sakg-dev/keebiter/kicad/3d_files/2u_stabalizer.step

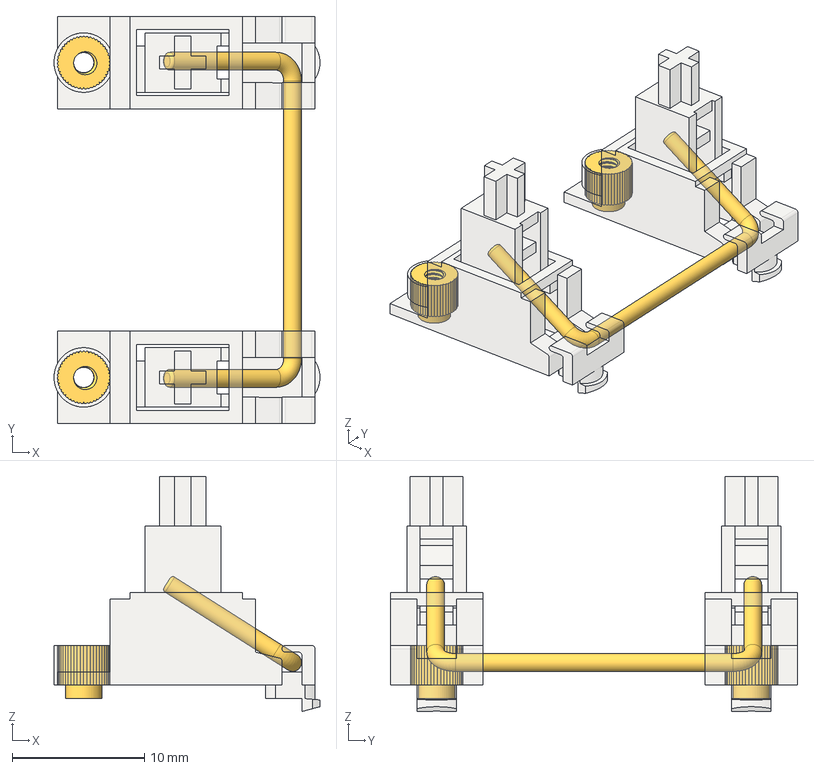
[picture p2: CAD file, 2026-10-14]
kicad/3d_files/2u_stabalizer.step
20.1 x 30.8 x 17.8 mm
Stabilizer Housing x 2
M2 Insert x 2
Stabilizer Insert x 2
2U Stabilizer Bar
