sakg-dev/keebiter/kicad/3d_files/keycaps/keycap_2_75u.step

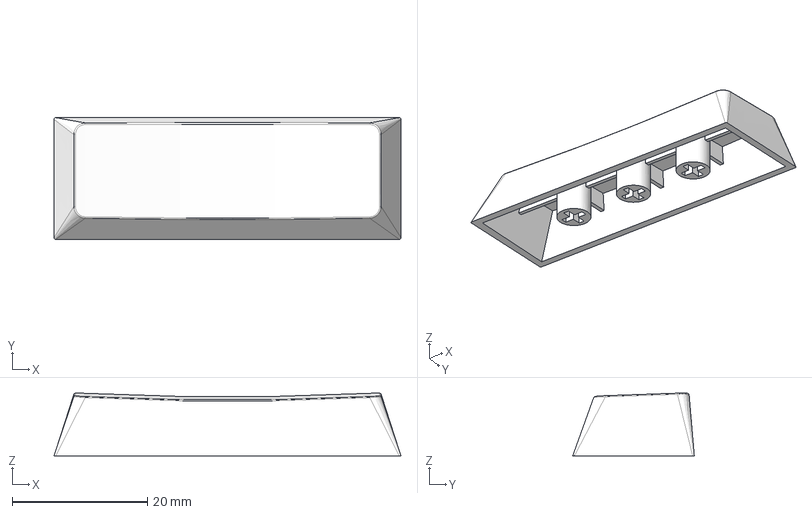
[picture p3: CAD file, 2026-10-14]
kicad/3d_files/keycaps/keycap_2_75u.step
51.3 x 18.0 x 9.30 mm
