sakg-dev/keebiter/kicad/kicad.step

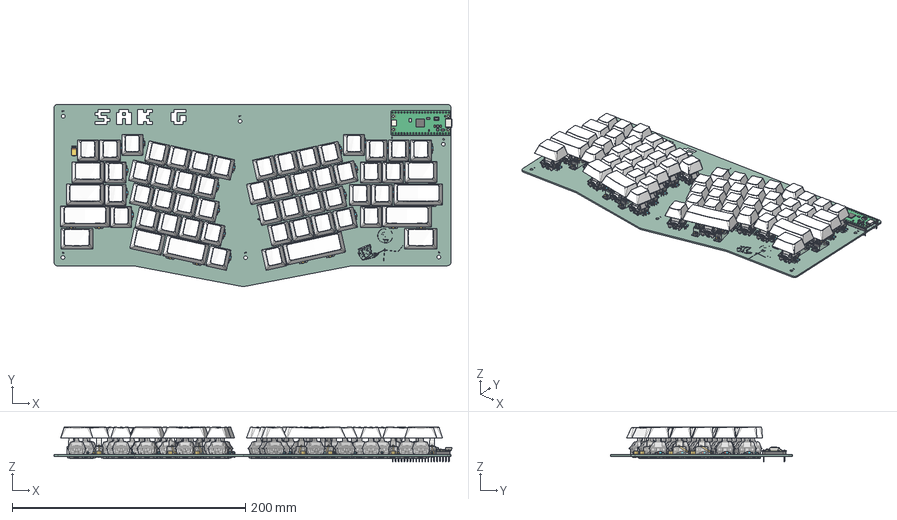
[picture p4: CAD file, 2026-10-14]
kicad/kicad.step
341.4 x 156.5 x 30.0 mm
D_DO-35_SOD27_P7.62mm_Horizontal x 61
C_0603_1608Metric x 12
Stabilizer Housing x 10
M2 Insert x 10
Stabilizer Insert x 10
2U Stabilizer Bar x 5
CP_EIA_7343_31_Kemet_D
RaspberryPi_Pico_H_Module_KiCad
RaspberryPi_Pico_Header_DIP-40_H2.54mm_KiCad
Pin1 x 61
Pin2 x 61
Pin3 x 61
Pin4 x 61
Contact x 122
KS-9 PRO3.0 FWQ_stp x 61
Product035 x 5
Product010 x 50
Product041
Product012 x 3
Product017
Product026
R_0603_1608Metric
kicad_silkscreen x 2
kicad_PCB
