sakg-dev/keebiter/onshape_exports/plate.stl

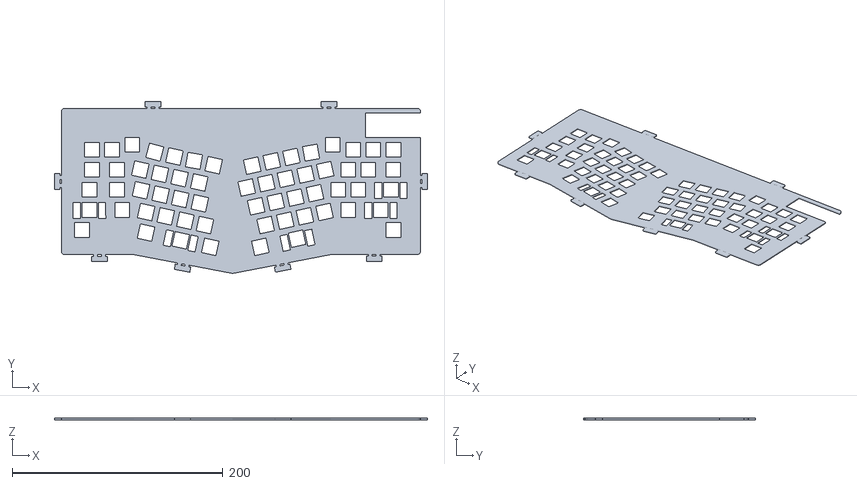
[picture p5: CAD file, 2026-10-14]
onshape_exports/plate.stl
353.6 x 163.0 x 1.50
