sakg-dev/keebiter/kicad/kicad.kicad_pcb

## KiCad design kicad/kicad.kicad_pcb (2026-10-14)

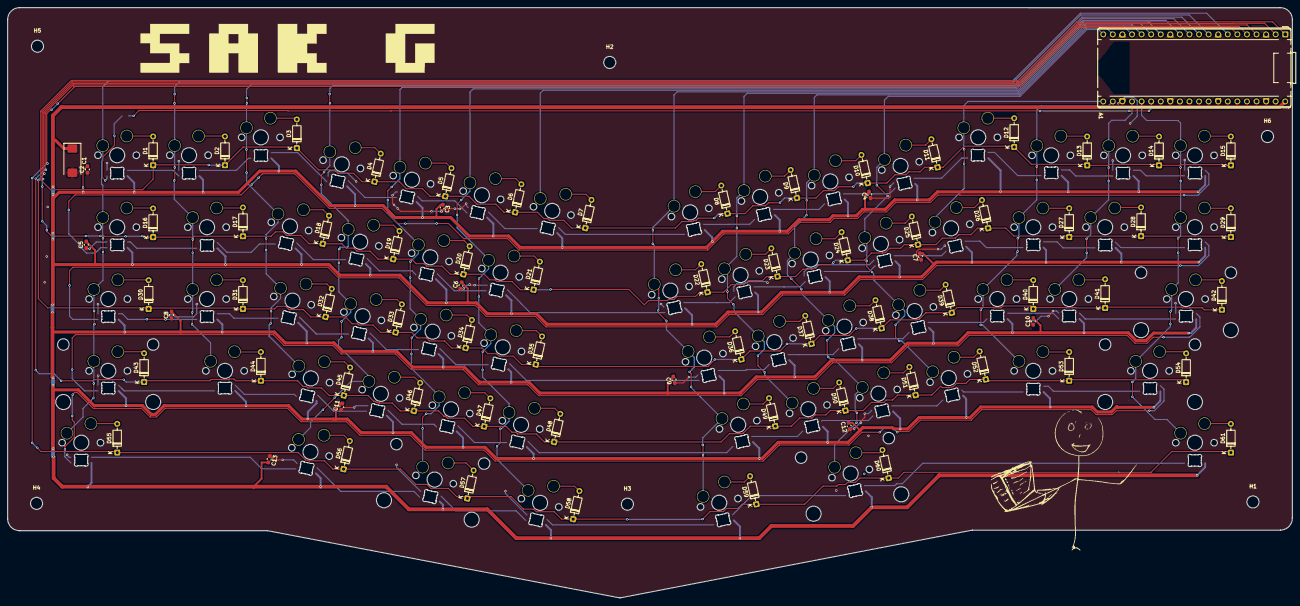
[picture p9: board kicad.kicad_pcb from above]

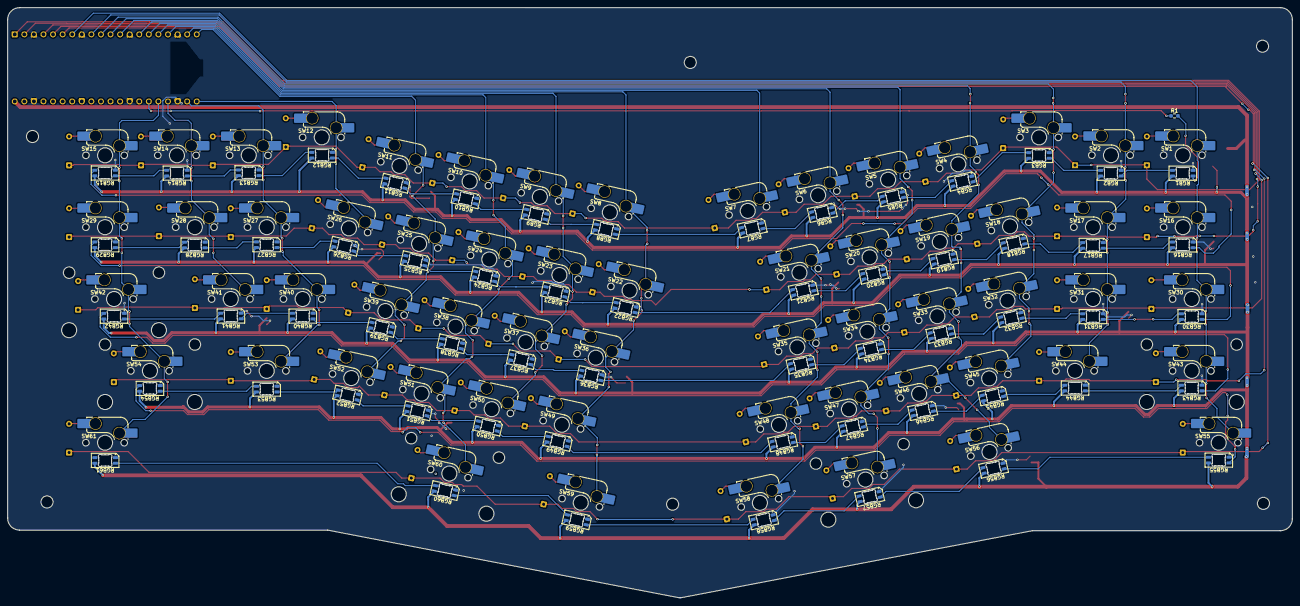
[picture p10: board kicad.kicad_pcb from below]

Board: 2 copper layers, 340.6 x 156.5 mm, 209 parts (123 on the bottom side), 145 nets.

Parts:
A1: RaspberryPi_Pico; RaspberryPi_Pico_Common_THT
C1: 470u; CP_EIA-7343-31_Kemet-D_HandSolder
C2, C3, C4, C5, C6, C7, C8, C9, C10, C11, C12, C13: 100n; C_0603_1608Metric_Pad1.08x0.95mm_HandSolder
D1, D2, D3, D4, D5, D6, D7, D8, D9, D10, D11, D12, D13, D14, D15, D16, D17, D18, D19, D20, D21, D22, D23, D24, D25, D26, D27, D28, D29, D30, D31, D32, D33, D34, D35, D36, D37, D38, D39, D40, D41, D42, D43, D44, D45, D46, D47, D48, D49, D50, D51, D52, D53, D54, D55, D56, D57, D58, D59, D60, D61: 1N4148; D_DO-35_SOD27_P7.62mm_Horizontal
H1, H2, H3, H4, H5, H6: MountingHole; MountingHole_3.2mm_M3
R1: 330; R_0603_1608Metric_Pad0.98x0.95mm_HandSolder
RGB1, RGB2, RGB3, RGB4, RGB5, RGB6, RGB7, RGB8, RGB9, RGB10, RGB11, RGB12, RGB13, RGB14, RGB15, RGB16, RGB17, RGB18, RGB19, RGB20, RGB21, RGB22, RGB23, RGB24, RGB25, RGB26, RGB27, RGB28, RGB29, RGB30, RGB31, RGB32, RGB33, RGB34, RGB35, RGB36, RGB37, RGB38, RGB39, RGB40, RGB41, RGB42, RGB43, RGB44, RGB45, RGB46, RGB47, RGB48, RGB49, RGB50, RGB51, RGB52, RGB53, RGB54, RGB55, RGB56, RGB57, RGB58, RGB59, RGB60, RGB61: SK6812MINI-E; LED_SK6812MINI-E_3.2x2.8mm_P1.5mm_ReverseMount
S1: MX_stab; STAB_MX_2.75u
S2: MX_stab; STAB_MX_2u
S3, S4, S5: MX_stab; STAB_MX_2.25u
SW1, SW2, SW3, SW4, SW5, SW6, SW7, SW8, SW9, SW10, SW11, SW12, SW13, SW14, SW15, SW16, SW17, SW18, SW19, SW20, SW21, SW22, SW23, SW24, SW25, SW26, SW27, SW28, SW29, SW30, SW31, SW32, SW33, SW34, SW35, SW36, SW37, SW38, SW39, SW40, SW41, SW42, SW43, SW44, SW45, SW46, SW47, SW48, SW49, SW50, SW51, SW52, SW53, SW54, SW55, SW56, SW57, SW58, SW59, SW60, SW61: SW_Push; SW_MX_HS_CPG151101S11_1u

Connections:
+5V: A1.40 (VBUS), C1.1, C2.2, C3.1, C4.2, C5.2, C6.2, C7.2, C8.2, C9.2, C10.2, C11.2, C12.2, C13.2, RGB1.3 (VDD), RGB2.3 (VDD), RGB3.3 (VDD), RGB4.3 (VDD), RGB5.3 (VDD), RGB6.3 (VDD), RGB7.3 (VDD), RGB8.3 (VDD), RGB9.3 (VDD), RGB10.3 (VDD), RGB11.3 (VDD), RGB12.3 (VDD), RGB13.3 (VDD), RGB14.3 (VDD), RGB15.3 (VDD), RGB16.3 (VDD), RGB17.3 (VDD), RGB18.3 (VDD), RGB19.3 (VDD), RGB20.3 (VDD), RGB21.3 (VDD), RGB22.3 (VDD), RGB23.3 (VDD), RGB24.3 (VDD), RGB25.3 (VDD), RGB26.3 (VDD), RGB27.3 (VDD), RGB28.3 (VDD), RGB29.3 (VDD), RGB30.3 (VDD), RGB31.3 (VDD), RGB32.3 (VDD), RGB33.3 (VDD), RGB34.3 (VDD), RGB35.3 (VDD), RGB36.3 (VDD), RGB37.3 (VDD), RGB38.3 (VDD), RGB39.3 (VDD), RGB40.3 (VDD), RGB41.3 (VDD), RGB42.3 (VDD), RGB43.3 (VDD), RGB44.3 (VDD), RGB45.3 (VDD), RGB46.3 (VDD), RGB47.3 (VDD), RGB48.3 (VDD), RGB49.3 (VDD), RGB50.3 (VDD), RGB51.3 (VDD), RGB52.3 (VDD), RGB53.3 (VDD), RGB54.3 (VDD), RGB55.3 (VDD), RGB56.3 (VDD), RGB57.3 (VDD), RGB58.3 (VDD), RGB59.3 (VDD), RGB60.3 (VDD), RGB61.3 (VDD)
/COL0: A1.7 (GPIO5), SW1.1, SW16.1, SW30.1, SW43.1, SW55.1
/COL1: A1.9 (GPIO6), SW2.1, SW17.1, SW31.1, SW44.1
/COL2: A1.10 (GPIO7), SW3.1, SW18.1, SW32.1, SW45.1
/COL3: A1.11 (GPIO8), SW4.1, SW19.1, SW33.1, SW46.1, SW56.1
/COL4: A1.12 (GPIO9), SW5.1, SW20.1, SW34.1, SW47.1, SW57.1
/COL5: A1.14 (GPIO10), SW6.1, SW21.1, SW35.1, SW48.1, SW58.1
/COL6: A1.15 (GPIO11), SW7.1
/COL7: A1.16 (GPIO12), SW8.1, SW22.1, SW36.1, SW49.1, SW59.1
/COL8: A1.17 (GPIO13), SW9.1, SW23.1, SW37.1, SW50.1
/COL9: A1.19 (GPIO14), SW10.1, SW24.1, SW38.1, SW51.1, SW60.1
/COL10: A1.20 (GPIO15), SW11.1, SW25.1, SW39.1, SW52.1
/COL11: A1.21 (GPIO16), SW12.1, SW26.1
/COL12: A1.22 (GPIO17), SW13.1, SW27.1, SW40.1, SW53.1
/COL13: A1.24 (GPIO18), SW14.1, SW28.1, SW41.1
/COL14: A1.25 (GPIO19), SW15.1, SW29.1, SW42.1, SW54.1, SW61.1
/RGB: A1.26 (GPIO20), R1.1
/ROW0: A1.1 (GPIO0), D1.1 (K), D2.1 (K), D3.1 (K), D4.1 (K), D5.1 (K), D6.1 (K), D7.1 (K), D8.1 (K), D9.1 (K), D10.1 (K), D11.1 (K), D12.1 (K), D13.1 (K), D14.1 (K), D15.1 (K)
/ROW1: A1.2 (GPIO1), D16.1 (K), D17.1 (K), D18.1 (K), D19.1 (K), D20.1 (K), D21.1 (K), D22.1 (K), D23.1 (K), D24.1 (K), D25.1 (K), D26.1 (K), D27.1 (K), D28.1 (K), D29.1 (K)
/ROW2: A1.4 (GPIO2), D30.1 (K), D31.1 (K), D32.1 (K), D33.1 (K), D34.1 (K), D35.1 (K), D36.1 (K), D37.1 (K), D38.1 (K), D39.1 (K), D40.1 (K), D41.1 (K), D42.1 (K)
/ROW3: A1.5 (GPIO3), D43.1 (K), D44.1 (K), D45.1 (K), D46.1 (K), D47.1 (K), D48.1 (K), D49.1 (K), D50.1 (K), D51.1 (K), D52.1 (K), D53.1 (K), D54.1 (K)
/ROW4: A1.6 (GPIO4), D55.1 (K), D56.1 (K), D57.1 (K), D58.1 (K), D59.1 (K), D60.1 (K), D61.1 (K)
GND: A1.3 (GND), A1.8 (GND), A1.13 (GND), A1.18 (GND), A1.23 (GND), A1.28 (GND), A1.38 (GND), C1.2, C2.1, C3.2, C4.1, C5.1, C6.1, C7.1, C8.1, C9.1, C10.1, C11.1, C12.1, C13.1, RGB1.1 (VSS), RGB2.1 (VSS), RGB3.1 (VSS), RGB4.1 (VSS), RGB5.1 (VSS), RGB6.1 (VSS), RGB7.1 (VSS), RGB8.1 (VSS), RGB9.1 (VSS), RGB10.1 (VSS), RGB11.1 (VSS), RGB12.1 (VSS), RGB13.1 (VSS), RGB14.1 (VSS), RGB15.1 (VSS), RGB16.1 (VSS), RGB17.1 (VSS), RGB18.1 (VSS), RGB19.1 (VSS), RGB20.1 (VSS), RGB21.1 (VSS), RGB22.1 (VSS), RGB23.1 (VSS), RGB24.1 (VSS), RGB25.1 (VSS), RGB26.1 (VSS), RGB27.1 (VSS), RGB28.1 (VSS), RGB29.1 (VSS), RGB30.1 (VSS), RGB31.1 (VSS), RGB32.1 (VSS), RGB33.1 (VSS), RGB34.1 (VSS), RGB35.1 (VSS), RGB36.1 (VSS), RGB37.1 (VSS), RGB38.1 (VSS), RGB39.1 (VSS), RGB40.1 (VSS), RGB41.1 (VSS), RGB42.1 (VSS), RGB43.1 (VSS), RGB44.1 (VSS), RGB45.1 (VSS), RGB46.1 (VSS), RGB47.1 (VSS), RGB48.1 (VSS), RGB49.1 (VSS), RGB50.1 (VSS), RGB51.1 (VSS), RGB52.1 (VSS), RGB53.1 (VSS), RGB54.1 (VSS), RGB55.1 (VSS), RGB56.1 (VSS), RGB57.1 (VSS), RGB58.1 (VSS), RGB59.1 (VSS), RGB60.1 (VSS), RGB61.1 (VSS)
unnamed: D1.2 (A), SW1.2
unnamed: D2.2 (A), SW2.2
unnamed: D3.2 (A), SW3.2
unnamed: D4.2 (A), SW4.2
unnamed: D5.2 (A), SW5.2
unnamed: D6.2 (A), SW6.2
unnamed: D7.2 (A), SW7.2
unnamed: D8.2 (A), SW8.2
unnamed: D9.2 (A), SW9.2
unnamed: D10.2 (A), SW10.2
unnamed: D11.2 (A), SW11.2
unnamed: D12.2 (A), SW12.2
unnamed: D13.2 (A), SW13.2
unnamed: D14.2 (A), SW14.2
unnamed: D15.2 (A), SW15.2
unnamed: D16.2 (A), SW16.2
unnamed: D17.2 (A), SW17.2
unnamed: D18.2 (A), SW18.2
unnamed: D19.2 (A), SW19.2
unnamed: D20.2 (A), SW20.2
unnamed: D21.2 (A), SW21.2
unnamed: D22.2 (A), SW22.2
unnamed: D23.2 (A), SW23.2
unnamed: D24.2 (A), SW24.2
unnamed: D25.2 (A), SW25.2
unnamed: D26.2 (A), SW26.2
unnamed: D27.2 (A), SW27.2
unnamed: D28.2 (A), SW28.2
unnamed: D29.2 (A), SW29.2
unnamed: D30.2 (A), SW30.2
unnamed: D31.2 (A), SW31.2
unnamed: D32.2 (A), SW32.2
unnamed: D33.2 (A), SW33.2
unnamed: D34.2 (A), SW34.2
unnamed: D35.2 (A), SW35.2
unnamed: D36.2 (A), SW36.2
unnamed: D37.2 (A), SW37.2
unnamed: D38.2 (A), SW38.2
unnamed: D39.2 (A), SW39.2
unnamed: D40.2 (A), SW40.2
unnamed: D41.2 (A), SW41.2
unnamed: D42.2 (A), SW42.2
unnamed: D43.2 (A), SW43.2
unnamed: D44.2 (A), SW44.2
unnamed: D45.2 (A), SW45.2
unnamed: D46.2 (A), SW46.2
unnamed: D47.2 (A), SW47.2
unnamed: D48.2 (A), SW48.2
unnamed: D49.2 (A), SW49.2
unnamed: D50.2 (A), SW50.2
unnamed: D51.2 (A), SW51.2
unnamed: D52.2 (A), SW52.2
unnamed: D53.2 (A), SW53.2
unnamed: D54.2 (A), SW54.2
unnamed: D55.2 (A), SW55.2
unnamed: D56.2 (A), SW56.2
unnamed: D57.2 (A), SW57.2
unnamed: D58.2 (A), SW58.2
unnamed: D59.2 (A), SW59.2
unnamed: D60.2 (A), SW60.2
unnamed: D61.2 (A), SW61.2
unnamed: R1.2, RGB1.2 (DIN)
unnamed: RGB1.4 (DOUT), RGB2.2 (DIN)
unnamed: RGB2.4 (DOUT), RGB3.2 (DIN)
unnamed: RGB3.4 (DOUT), RGB4.2 (DIN)
unnamed: RGB4.4 (DOUT), RGB5.2 (DIN)
unnamed: RGB5.4 (DOUT), RGB6.2 (DIN)
unnamed: RGB6.4 (DOUT), RGB7.2 (DIN)
unnamed: RGB7.4 (DOUT), RGB8.2 (DIN)
unnamed: RGB8.4 (DOUT), RGB9.2 (DIN)
unnamed: RGB9.4 (DOUT), RGB10.2 (DIN)
unnamed: RGB10.4 (DOUT), RGB11.2 (DIN)
unnamed: RGB11.4 (DOUT), RGB12.2 (DIN)
unnamed: RGB12.4 (DOUT), RGB13.2 (DIN)
unnamed: RGB13.4 (DOUT), RGB14.2 (DIN)
unnamed: RGB14.4 (DOUT), RGB15.2 (DIN)
unnamed: RGB15.4 (DOUT), RGB16.2 (DIN)
unnamed: RGB16.4 (DOUT), RGB17.2 (DIN)
unnamed: RGB17.4 (DOUT), RGB18.2 (DIN)
unnamed: RGB18.4 (DOUT), RGB19.2 (DIN)
unnamed: RGB19.4 (DOUT), RGB20.2 (DIN)
unnamed: RGB20.4 (DOUT), RGB21.2 (DIN)
unnamed: RGB21.4 (DOUT), RGB22.2 (DIN)
unnamed: RGB22.4 (DOUT), RGB23.2 (DIN)
unnamed: RGB23.4 (DOUT), RGB24.2 (DIN)
unnamed: RGB24.4 (DOUT), RGB25.2 (DIN)
unnamed: RGB25.4 (DOUT), RGB26.2 (DIN)
unnamed: RGB26.4 (DOUT), RGB27.2 (DIN)
unnamed: RGB27.4 (DOUT), RGB28.2 (DIN)
unnamed: RGB28.4 (DOUT), RGB29.2 (DIN)
unnamed: RGB29.4 (DOUT), RGB30.2 (DIN)
unnamed: RGB30.4 (DOUT), RGB31.2 (DIN)
unnamed: RGB31.4 (DOUT), RGB32.2 (DIN)
unnamed: RGB32.4 (DOUT), RGB33.2 (DIN)
unnamed: RGB33.4 (DOUT), RGB34.2 (DIN)
unnamed: RGB34.4 (DOUT), RGB35.2 (DIN)
unnamed: RGB35.4 (DOUT), RGB36.2 (DIN)
unnamed: RGB36.4 (DOUT), RGB37.2 (DIN)
unnamed: RGB37.4 (DOUT), RGB38.2 (DIN)
unnamed: RGB38.4 (DOUT), RGB39.2 (DIN)
unnamed: RGB39.4 (DOUT), RGB40.2 (DIN)
unnamed: RGB40.4 (DOUT), RGB41.2 (DIN)
unnamed: RGB41.4 (DOUT), RGB42.2 (DIN)
unnamed: RGB42.4 (DOUT), RGB43.2 (DIN)
unnamed: RGB43.4 (DOUT), RGB44.2 (DIN)
unnamed: RGB44.4 (DOUT), RGB45.2 (DIN)
unnamed: RGB45.4 (DOUT), RGB46.2 (DIN)
unnamed: RGB46.4 (DOUT), RGB47.2 (DIN)
unnamed: RGB47.4 (DOUT), RGB48.2 (DIN)
unnamed: RGB48.4 (DOUT), RGB49.2 (DIN)
unnamed: RGB49.4 (DOUT), RGB50.2 (DIN)
unnamed: RGB50.4 (DOUT), RGB51.2 (DIN)
unnamed: RGB51.4 (DOUT), RGB52.2 (DIN)
unnamed: RGB52.4 (DOUT), RGB53.2 (DIN)
unnamed: RGB53.4 (DOUT), RGB54.2 (DIN)
unnamed: RGB54.4 (DOUT), RGB55.2 (DIN)
unnamed: RGB55.4 (DOUT), RGB56.2 (DIN)
unnamed: RGB56.4 (DOUT), RGB57.2 (DIN)
unnamed: RGB57.4 (DOUT), RGB58.2 (DIN)
unnamed: RGB58.4 (DOUT), RGB59.2 (DIN)
unnamed: RGB59.4 (DOUT), RGB60.2 (DIN)
unnamed: RGB60.4 (DOUT), RGB61.2 (DIN)
