sakg-dev/keebiter/(commit log)

2026-10-14 sm improvements on pcb, added stabalizers' 3d model and using 2.75u of right space bar instead of 3u
2026-10-15 added final assembly, in layout, rmved delete key and made it super key - for other use
